ldab/Node-RED-Energy-Harvesting-dashboard/extras/SchematicsforESP32.pdf

# USB Part

# Power Part

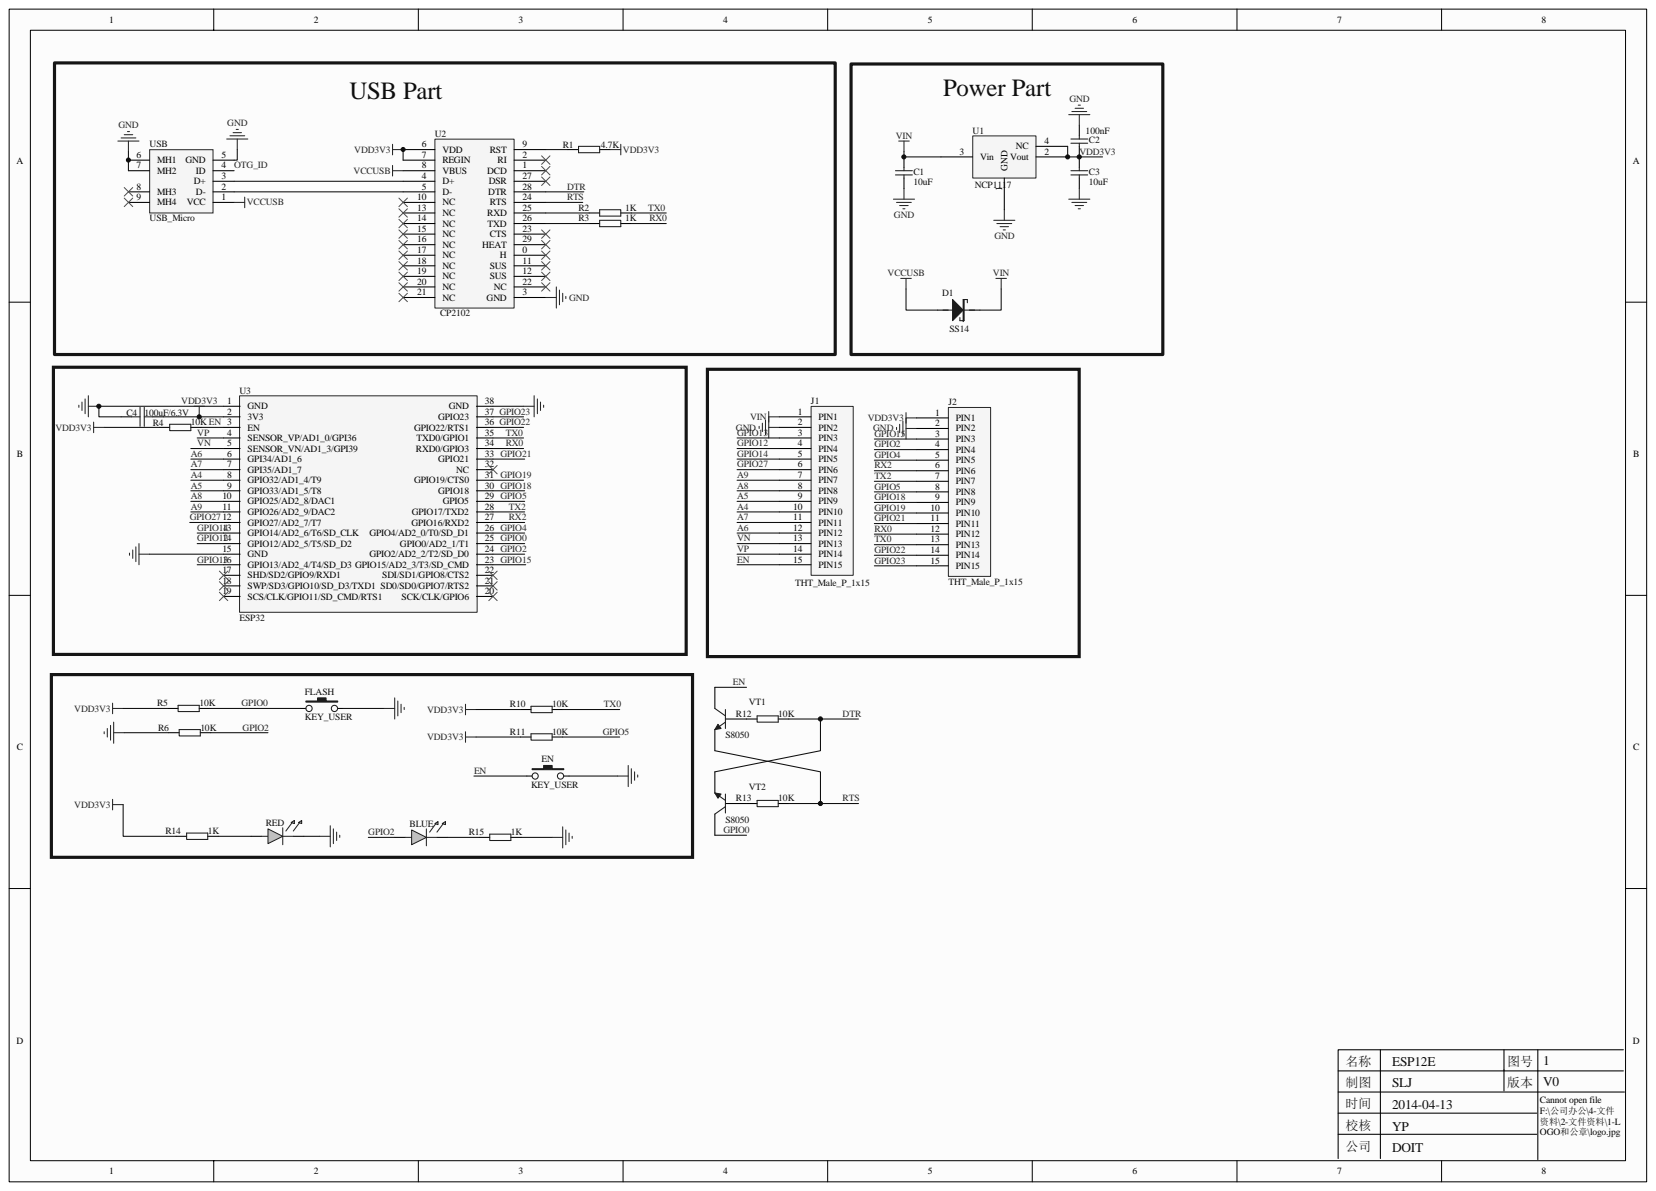
[picture p11: page 1]
