ldab/Node-RED-Energy-Harvesting-dashboard/PCB/KiCad/MoreE u-blox E-PEAS.kicad_pcb

## KiCad design PCB/KiCad/MoreE u-blox E-PEAS.kicad_pcb (2019-07-01)

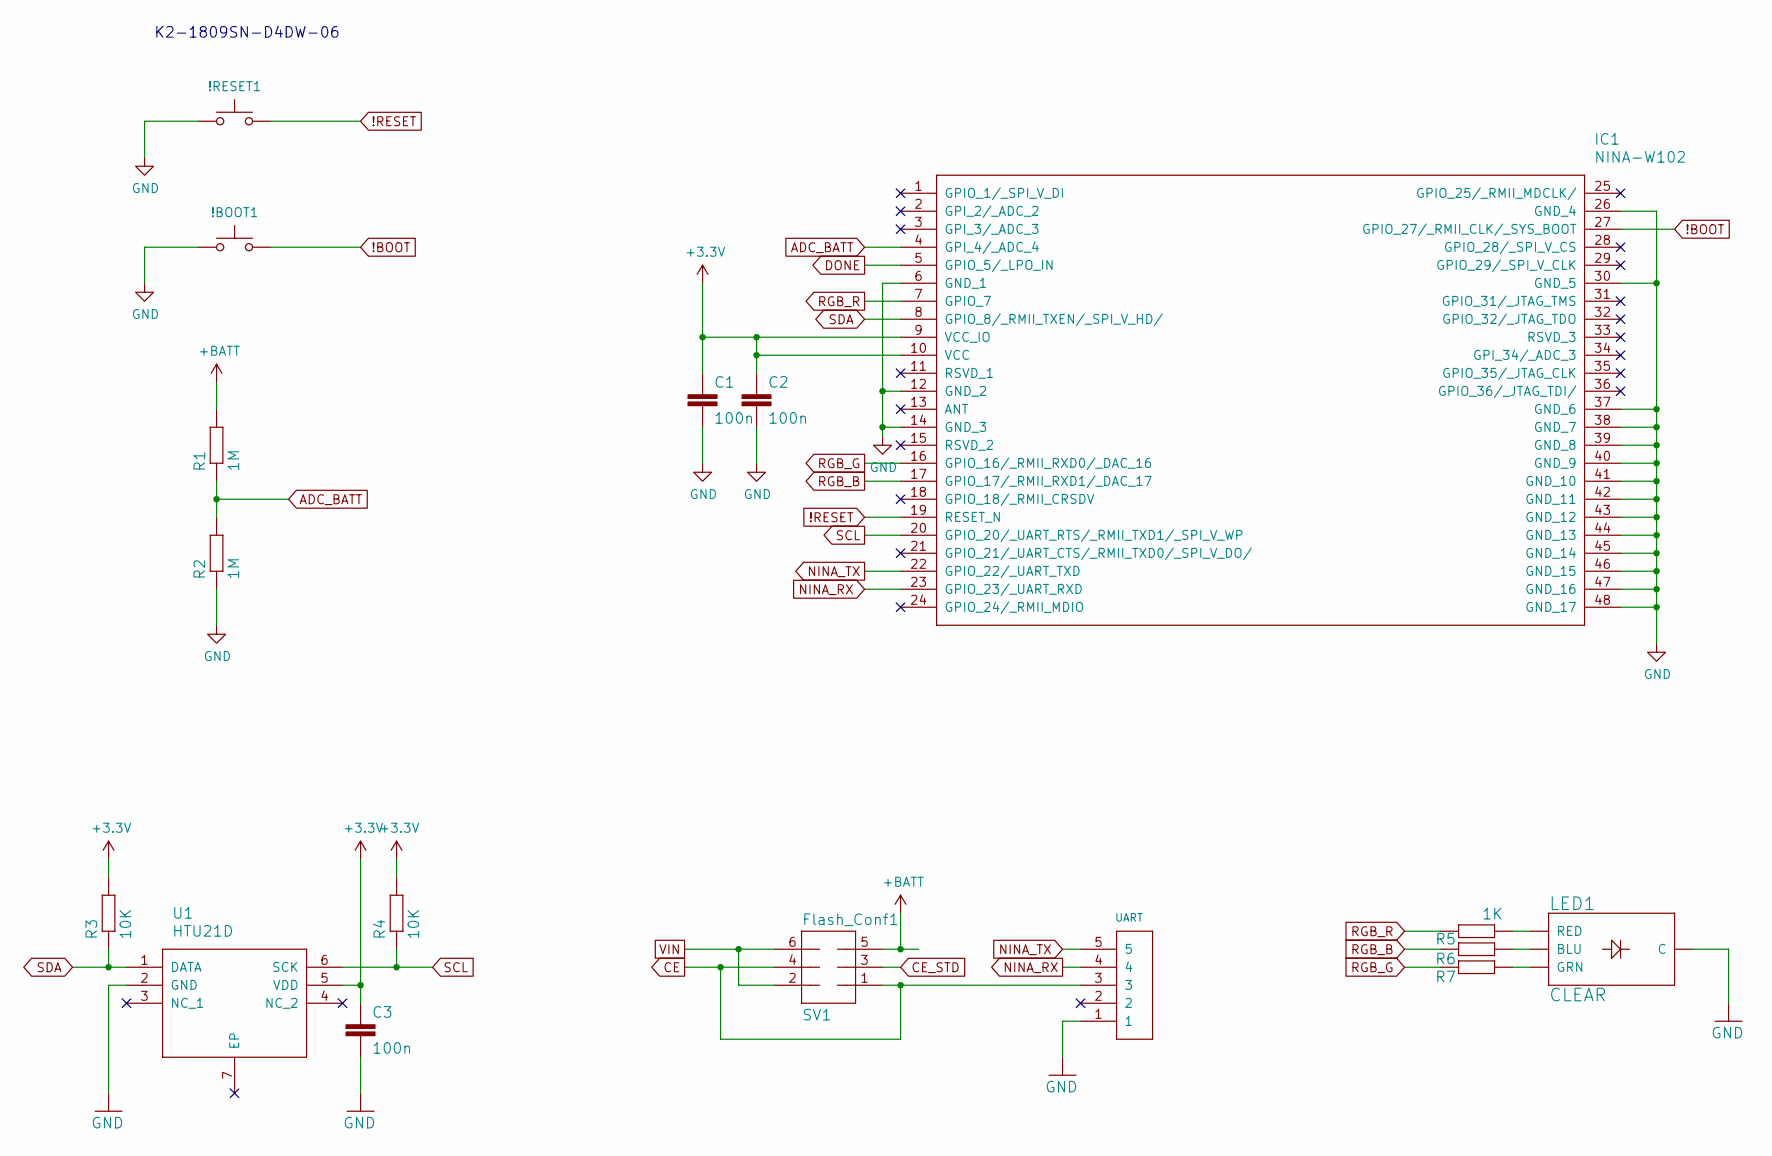
[picture p15: schematic MoreE_u-blox_E-PEAS_1.sch, MoreE u-blox E-PEAS Energy Harvesting]

Parts:
!BOOT1: SW_Push_KMR2; SW_Push_1P1T_NO_CK_KMR2
!RESET1: SW_Push_KMR2; SW_Push_1P1T_NO_CK_KMR2
C1, C2, C3: 100n; C_0805_2012Metric
Flash_Conf1: SV1; PinHeader_2x03_P2.54mm_Vertical
IC1: NINA-W102; NINAW102
LED1: CLEAR; LED_D5.0mm-4_RGB
R1, R2: 1M; R_0805_2012Metric
R3, R4: 10K; R_0805_2012Metric
R5, R6, R7: 1K; R_0805_2012Metric
SV2: UART; PinHeader_1x05_P2.54mm_Vertical
U1: HTU21D; DFN-6-1EP_3x3mm_P1mm_EP1.5x2.4mm

Connections:
!BOOT: !BOOT1.2, IC1.27 (GPIO_27/_RMII_CLK/_SYS_BOOT)
!RESET: !RESET1.2, IC1.19 (RESET_N)
+3V3: C1.1, C2.1, C3.1, IC1.9 (VCC_IO), IC1.10 (VCC), R3.2, R4.2, U1.5 (VDD); also elsewhere on the board
+BATT: Flash_Conf1.5, R1.2; also elsewhere on the board
ADC_BATT: IC1.4 (GPI_4/_ADC_4), R1.1, R2.2
CE: Flash_Conf1.1, Flash_Conf1.4, SV2.3; also elsewhere on the board
CE_STD: Flash_Conf1.3; also elsewhere on the board
DONE: IC1.5 (GPIO_5/_LPO_IN); also elsewhere on the board
GND: !BOOT1.1, !RESET1.1, C1.2, C2.2, C3.2, IC1.6 (GND_1), IC1.12 (GND_2), IC1.14 (GND_3), IC1.26 (GND_4), IC1.30 (GND_5), IC1.37 (GND_6), IC1.38 (GND_7), IC1.39 (GND_8), IC1.40 (GND_9), IC1.41 (GND_10), IC1.42 (GND_11), IC1.43 (GND_12), IC1.44 (GND_13), IC1.45 (GND_14), IC1.46 (GND_15), IC1.47 (GND_16), IC1.48 (GND_17), LED1.2 (C), R2.1, SV2.1, U1.2 (GND); also elsewhere on the board
NINA_RX: IC1.23 (GPIO_23/_UART_RXD), SV2.4
NINA_TX: IC1.22 (GPIO_22/_UART_TXD), SV2.5
unnamed: LED1.1 (RED), R5.1
unnamed: LED1.3 (GRN), R7.1
unnamed: LED1.4 (BLU), R6.1
RGB_B: IC1.17 (GPIO_17/_RMII_RXD1/_DAC_17), R6.2
RGB_G: IC1.16 (GPIO_16/_RMII_RXD0/_DAC_16), R7.2
RGB_R: IC1.7 (GPIO_7), R5.2
SCL: IC1.20 (GPIO_20/_UART_RTS/_RMII_TXD1/_SPI_V_WP), R4.1, U1.6 (SCK)
SDA: IC1.8 (GPIO_8/_RMII_TXEN/_SPI_V_HD/), R3.1, U1.1 (DATA)
VIN: Flash_Conf1.2, Flash_Conf1.6; also elsewhere on the board

Notes on the sheet:
K2-1809SN-D4DW-06

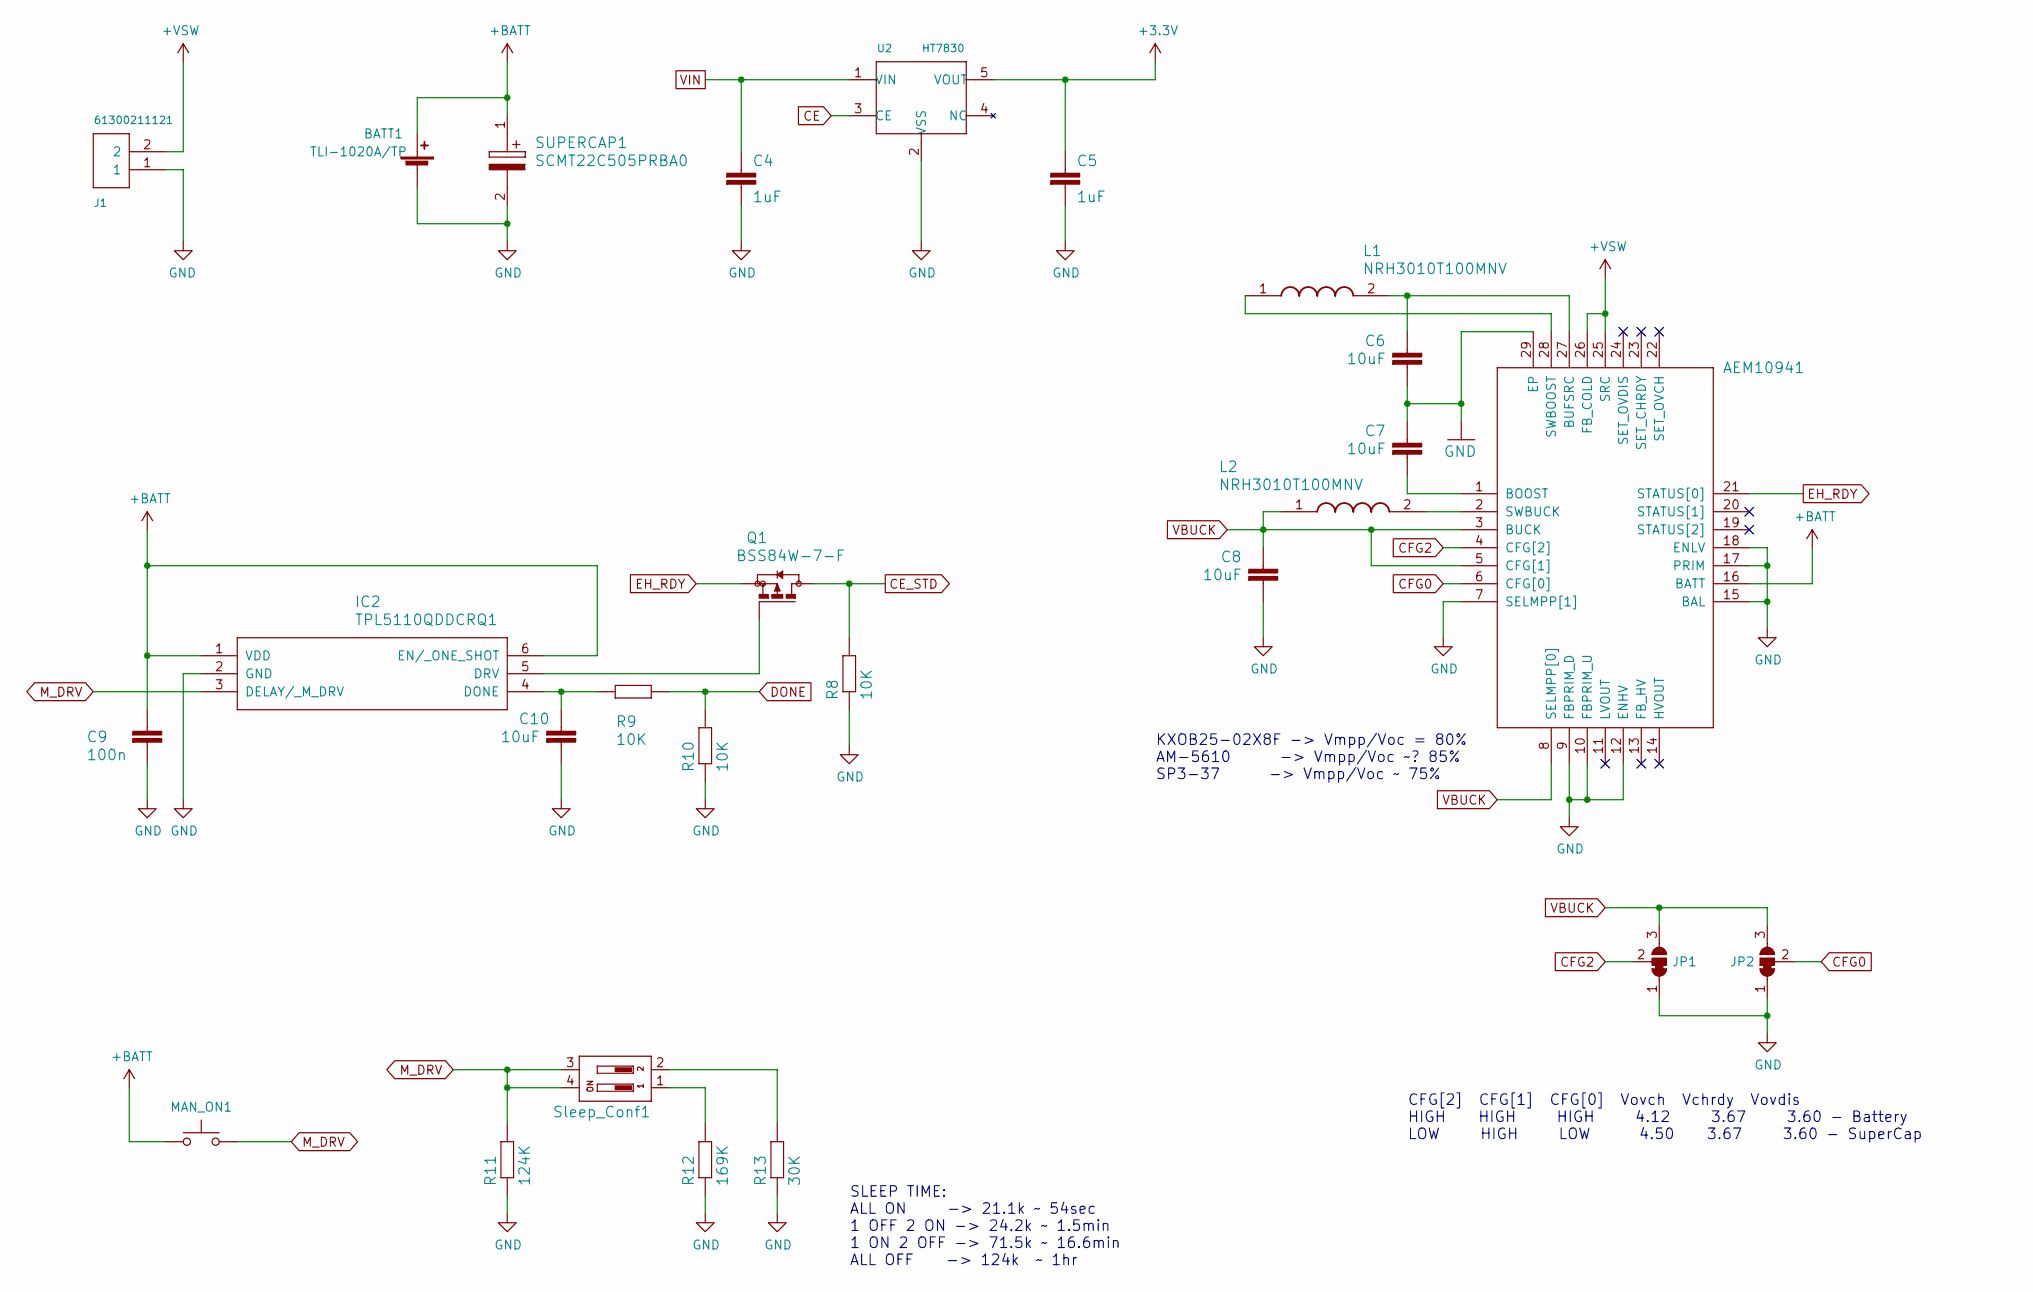
[picture p16: schematic MoreE_u-blox_E-PEAS_2.sch, MoreE u-blox E-PEAS Energy Harvesting]

Parts:
AEM10941: AEM10941; QFN-28-1EP_5x5mm_P0.5mm_EP3.35x3.35mm
BATT1: TLI-1020A/TP
C4, C5: 1uF; C_0805_2012Metric
C6, C7, C8, C10: 10uF; C_0805_2012Metric
C9: 100n; C_0805_2012Metric
IC2: TPL5110QDDCRQ1; SOT-23-6
J1: 61300211121; PinHeader_1x02_P2.54mm_Vertical
JP1, JP2: SolderJumper_3_Bridged12; SolderJumper-3_P1.3mm_Bridged12_RoundedPad1.0x1.5mm
L1, L2: NRH3010T100MNV; L_Taiyo-Yuden_NRH30xx
MAN_ON1: SW_Push_KMR2; SW_Push_1P1T_NO_CK_KMR2
Q1: BSS84W-7-F; SOT-323_SC-70
R8, R9, R10: 10K; R_0805_2012Metric
R11: 124K; R_0805_2012Metric
R12: 169K; R_0805_2012Metric
R13: 30K; R_0805_2012Metric
SUPERCAP1: SCMT22C505PRBA0
Sleep_Conf1: Sleep Conf; SW_DIP_SPSTx02_Slide_9.78x7.26mm_W7.62mm_P2.54mm
U2: HT7830; SOT-23-5

Connections:
+3V3: C5.1, U2.5 (VOUT); also elsewhere on the board
+BATT: AEM10941.16 (BATT), BATT1.1 (+), C9.1, IC2.1 (VDD), IC2.6 (EN/_ONE_SHOT), MAN_ON1.1, SUPERCAP1.1 (-); also elsewhere on the board
+VSW: AEM10941.25 (SRC), AEM10941.26 (FB_COLD), J1.2
CE: U2.3 (CE); also elsewhere on the board
CE_STD: Q1.3 (D), R8.2; also elsewhere on the board
CFG0: AEM10941.6 (CFG[0]), JP2.2 (C)
CFG2: AEM10941.4 (CFG[2]), JP1.2 (C)
DONE: R9.2, R10.2; also elsewhere on the board
EH_RDY: AEM10941.21 (STATUS[0]), Q1.2 (S)
GND: AEM10941.7 (SELMPP[1]), AEM10941.9 (FBPRIM_D), AEM10941.10 (FBPRIM_U), AEM10941.12 (ENHV), AEM10941.15 (BAL), AEM10941.17 (PRIM), AEM10941.18 (ENLV), AEM10941.29 (EP), BATT1.2 (-), C4.2, C5.2, C6.2, C7.1, C8.2, C9.2, C10.2, IC2.2 (GND), J1.1, JP1.1 (A), JP2.1 (A), R8.1, R10.1, R11.1, R12.1, R13.1, SUPERCAP1.2 (+), U2.2 (VSS); also elsewhere on the board
M_DRV: IC2.3 (DELAY/_M_DRV), MAN_ON1.2, R11.2, Sleep_Conf1.3, Sleep_Conf1.4
unnamed: AEM10941.1 (BOOST), C7.2
unnamed: AEM10941.2 (SWBUCK), L2.2
unnamed: AEM10941.27 (BUFSRC), C6.1, L1.2
unnamed: AEM10941.28 (SWBOOST), L1.1
unnamed: C10.1, IC2.4 (DONE), R9.1
unnamed: IC2.5 (DRV), Q1.1 (G)
unnamed: R12.2, Sleep_Conf1.1
unnamed: R13.2, Sleep_Conf1.2
VBUCK: AEM10941.3 (BUCK), AEM10941.5 (CFG[1]), AEM10941.8 (SELMPP[0]), C8.1, JP1.3 (B), JP2.3 (B), L2.1
VIN: C4.1, U2.1 (VIN); also elsewhere on the board

Notes on the sheet:
SLEEP TIME: ALL ON -> 21.1k ~~ 54sec 1 OFF 2 ON -> 24.2k ~~ 1.5min 1 ON 2 OFF -> 71.5k ~~ 16.6min ALL OFF -> 124k ~~ 1hr
CFG[2] CFG[1] CFG[0] Vovch Vchrdy Vovdis HIGH HIGH HIGH 4.12 3.67 3.60 - Battery LOW HIGH LOW 4.50 3.67 3.60 - SuperCap
KXOB25-02X8F -> Vmpp/Voc = 80% AM-5610 -> Vmpp/Voc ~~? 85% SP3-37 -> Vmpp/Voc ~~ 75%

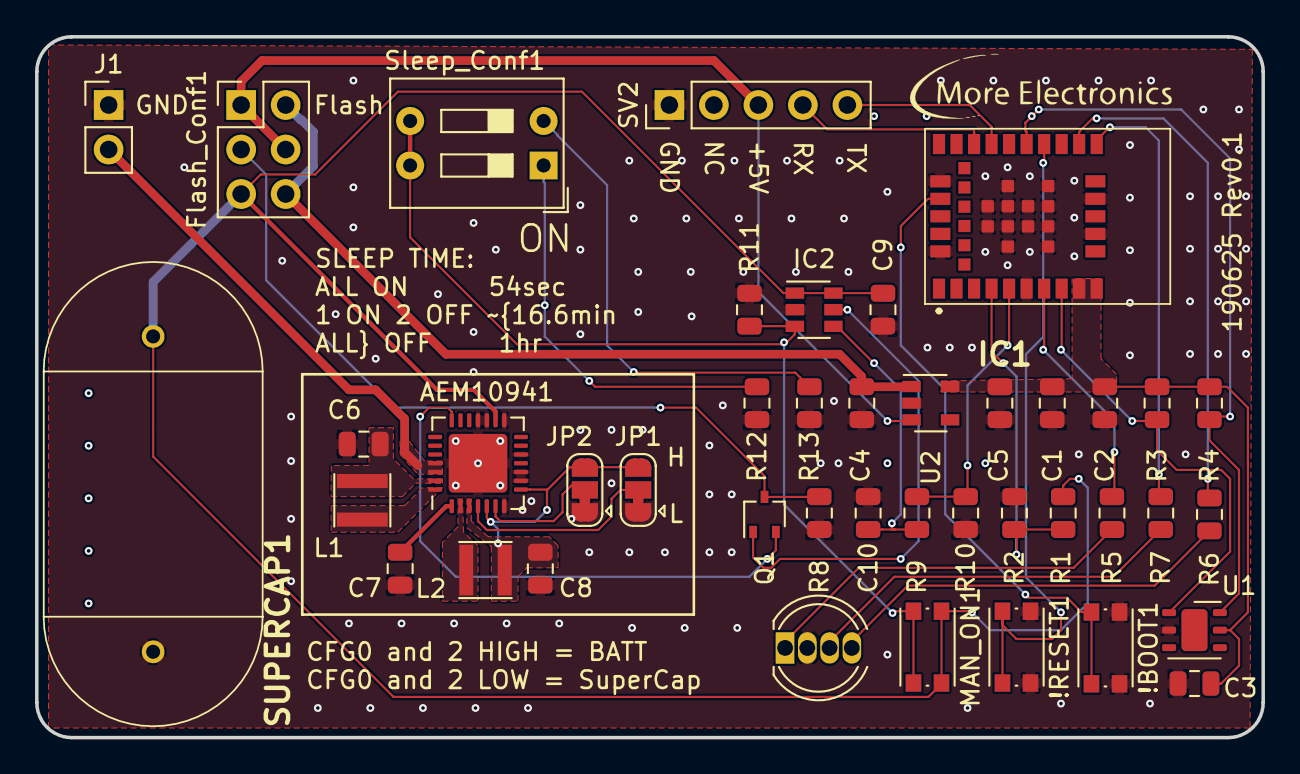
[picture p17: board MoreE u-blox E-PEAS.kicad_pcb from above]

Board: 2 copper layers, 70.0 x 40.0 mm, 42 parts (0 on the bottom side), 34 nets.
