ldab/Node-RED-Energy-Harvesting-dashboard/(commit log)

2019-06-14 initial comit
    [partitions_custom.csv]
2019-07-05 release node-red flow
2019-07-06 fix "running for" when device offiline for too long
2019-07-08 int overflow and partition table
    [partitions_custom.csv]
2019-07-20 update dashboard and include enclosure
2019-08-16 updated flow
2019-08-26 included programming and power details
    [MoreE u-blox E-PEAS.sch]
