ldab/Node-RED-Energy-Harvesting-dashboard/(notices)

Notices in the files:
README.md:
License: MIT
